ofthedove/tv-timer/pcbs/TV Timer - Digit.dxf

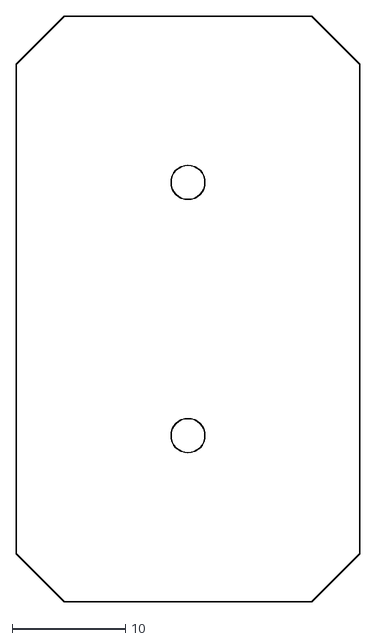
[picture p4: CAD file, 2026-08-09]
pcbs/TV Timer - Digit.dxf
30.4 x 51.7
