ofthedove/tv-timer/pcbs/TV Timer - Colon - Frame.dxf

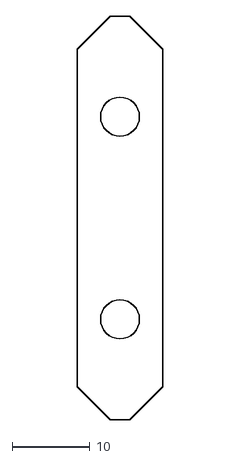
[picture p5: CAD file, 2026-08-08]
pcbs/TV Timer - Colon - Frame.dxf
11.0 x 51.7
