ofthedove/tv-timer/pcbs/TV Timer - Keypad.dxf

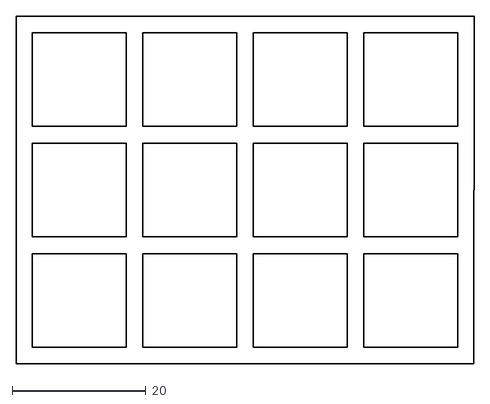
[picture p6: CAD file, 2026-08-08]
pcbs/TV Timer - Keypad.dxf
68.4 x 51.9
