ofthedove/tv-timer/pcbs/TV Timer - Indicators.dxf

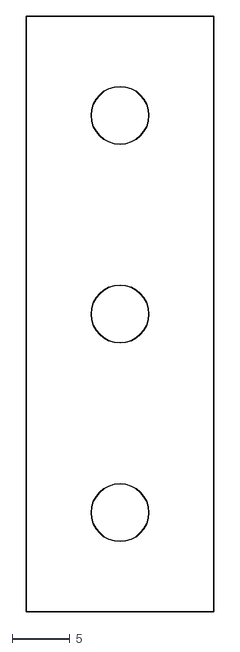
[picture p7: CAD file, 2026-08-08]
pcbs/TV Timer - Indicators.dxf
16.2 x 51.7
