ofthedove/tv-timer/pcbs/tv-timer-pcbs/tv-timer-pcbs.kicad_pcb

## KiCad design pcbs/tv-timer-pcbs/tv-timer-pcbs.kicad_pcb (2026-08-10)

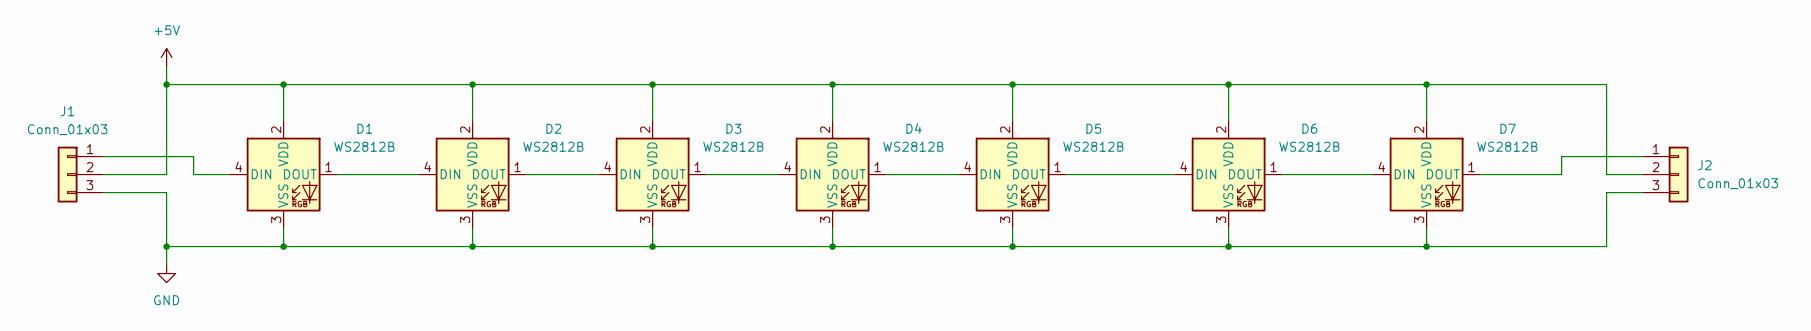
[picture p8: schematic tv-timer-pcbs.kicad_sch]

Parts:
D1, D2, D3, D4, D5, D6, D7: WS2812B; LED_D5.0mm-4_RGB_Wide_Pins
J1, J2: Conn_01x03; JST_XH_B3B-XH-AM_1x03_P2.50mm_Vertical

Connections:
+5V: D1.2 (VDD), D2.2 (VDD), D3.2 (VDD), D4.2 (VDD), D5.2 (VDD), D6.2 (VDD), D7.2 (VDD), J1.2, J2.2
GND: D1.3 (VSS), D2.3 (VSS), D3.3 (VSS), D4.3 (VSS), D5.3 (VSS), D6.3 (VSS), D7.3 (VSS), J1.3, J2.3
unnamed: D1.4 (DIN), J1.1
unnamed: D1.1 (DOUT), D2.4 (DIN)
unnamed: D2.1 (DOUT), D3.4 (DIN)
unnamed: D3.1 (DOUT), D4.4 (DIN)
unnamed: D4.1 (DOUT), D5.4 (DIN)
unnamed: D5.1 (DOUT), D6.4 (DIN)
unnamed: D6.1 (DOUT), D7.4 (DIN)
unnamed: D7.1 (DOUT), J2.1

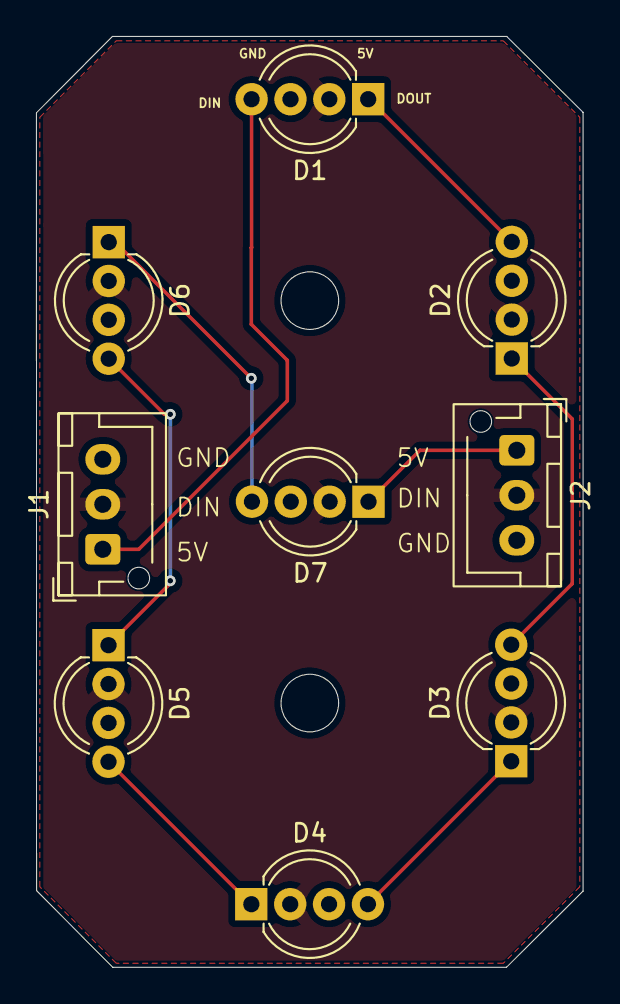
[picture p9: board tv-timer-pcbs.kicad_pcb from above]

Board: 2 copper layers, 30.4 x 51.7 mm, 9 parts (0 on the bottom side), 10 nets.
