ofthedove/tv-timer/pcbs/tv-timer-keypad/tv-timer-keypad.kicad_pcb

## KiCad design pcbs/tv-timer-keypad/tv-timer-keypad.kicad_pcb (2026-08-10)

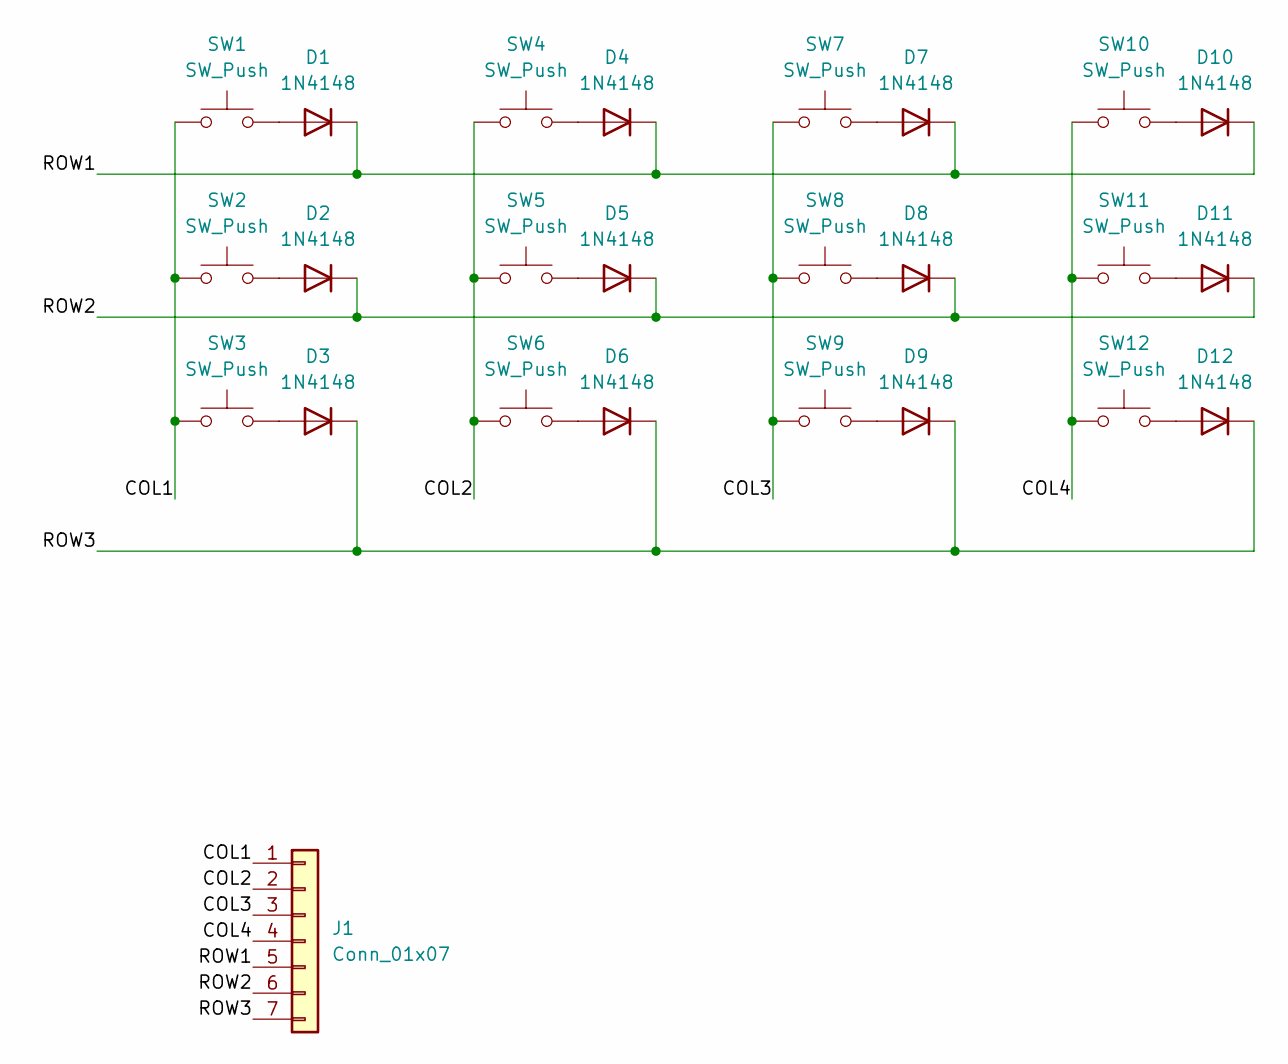
[picture p10: schematic tv-timer-keypad.kicad_sch]

Parts:
D1, D2, D3, D4, D5, D6, D7, D8, D9, D10, D11, D12: 1N4148; D_DO-35_SOD27_P7.62mm_Horizontal
J1: Conn_01x07; JST_XH_B7B-XH-AM_1x07_P2.50mm_Vertical
SW1, SW2, SW3, SW4, SW5, SW6, SW7, SW8, SW9, SW10, SW11, SW12: SW_Push; SW_Hybrid_Cherry_MX_Alps

Connections:
/COL1: J1.1, SW1.1, SW2.1, SW3.1
/COL2: J1.2, SW4.1, SW5.1, SW6.1
/COL3: J1.3, SW7.1, SW8.1, SW9.1
/COL4: J1.4, SW10.1, SW11.1, SW12.1
/ROW1: D1.1 (K), D4.1 (K), D7.1 (K), D10.1 (K), J1.5
/ROW2: D2.1 (K), D5.1 (K), D8.1 (K), D11.1 (K), J1.6
/ROW3: D3.1 (K), D6.1 (K), D9.1 (K), D12.1 (K), J1.7
unnamed: D1.2 (A), SW1.2
unnamed: D2.2 (A), SW2.2
unnamed: D3.2 (A), SW3.2
unnamed: D4.2 (A), SW4.2
unnamed: D5.2 (A), SW5.2
unnamed: D6.2 (A), SW6.2
unnamed: D7.2 (A), SW7.2
unnamed: D8.2 (A), SW8.2
unnamed: D9.2 (A), SW9.2
unnamed: D10.2 (A), SW10.2
unnamed: D11.2 (A), SW11.2
unnamed: D12.2 (A), SW12.2

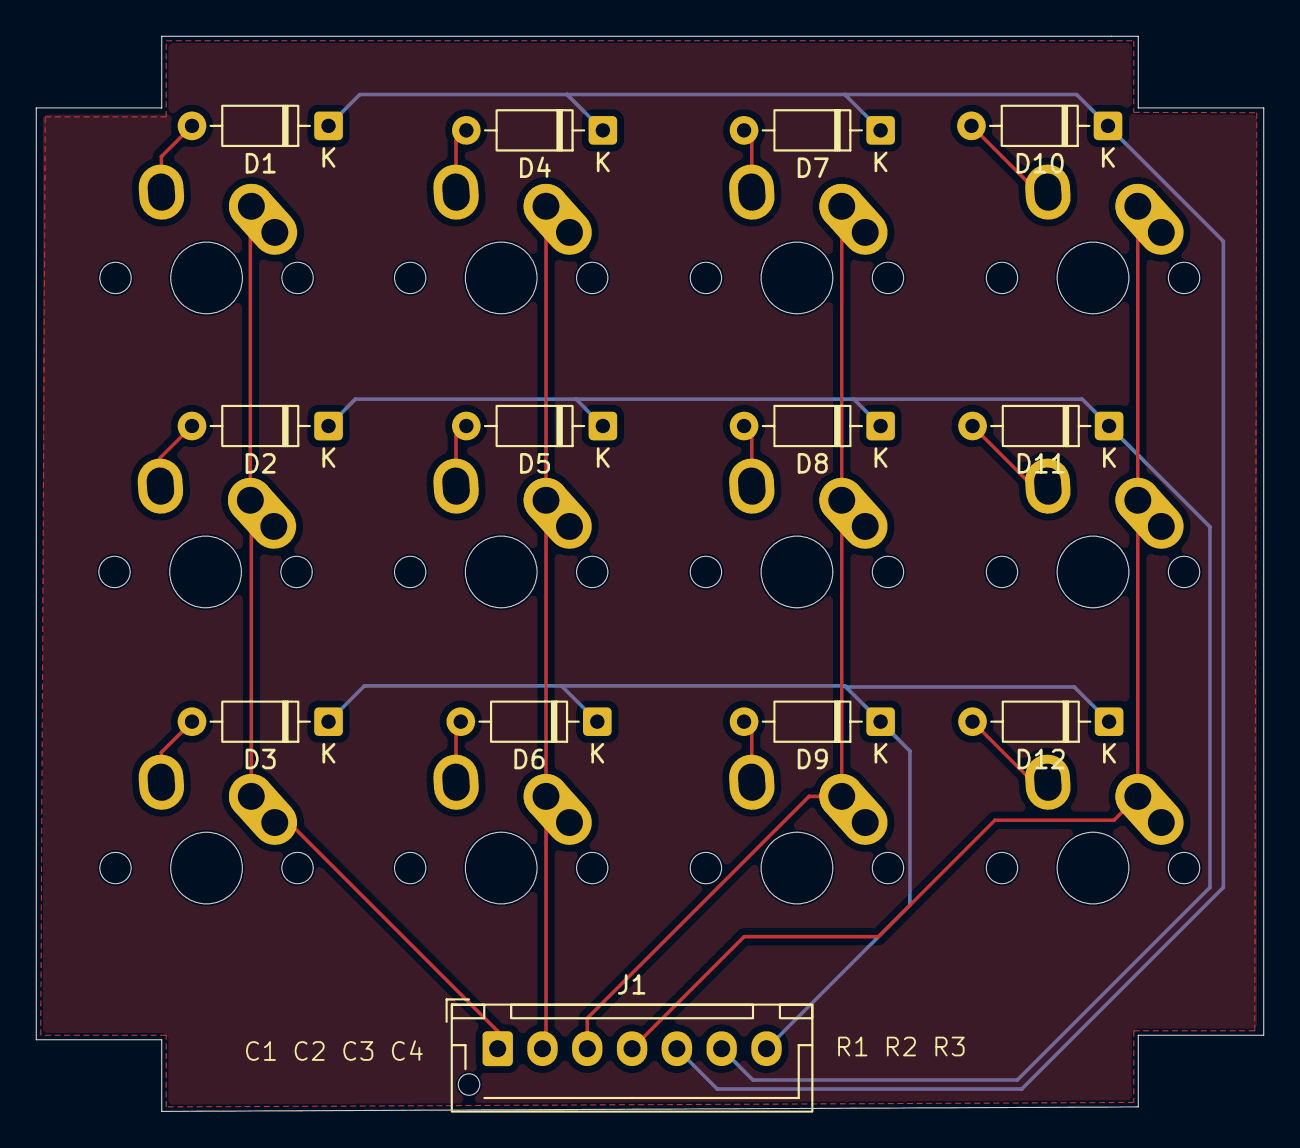
[picture p11: board tv-timer-keypad.kicad_pcb from above]

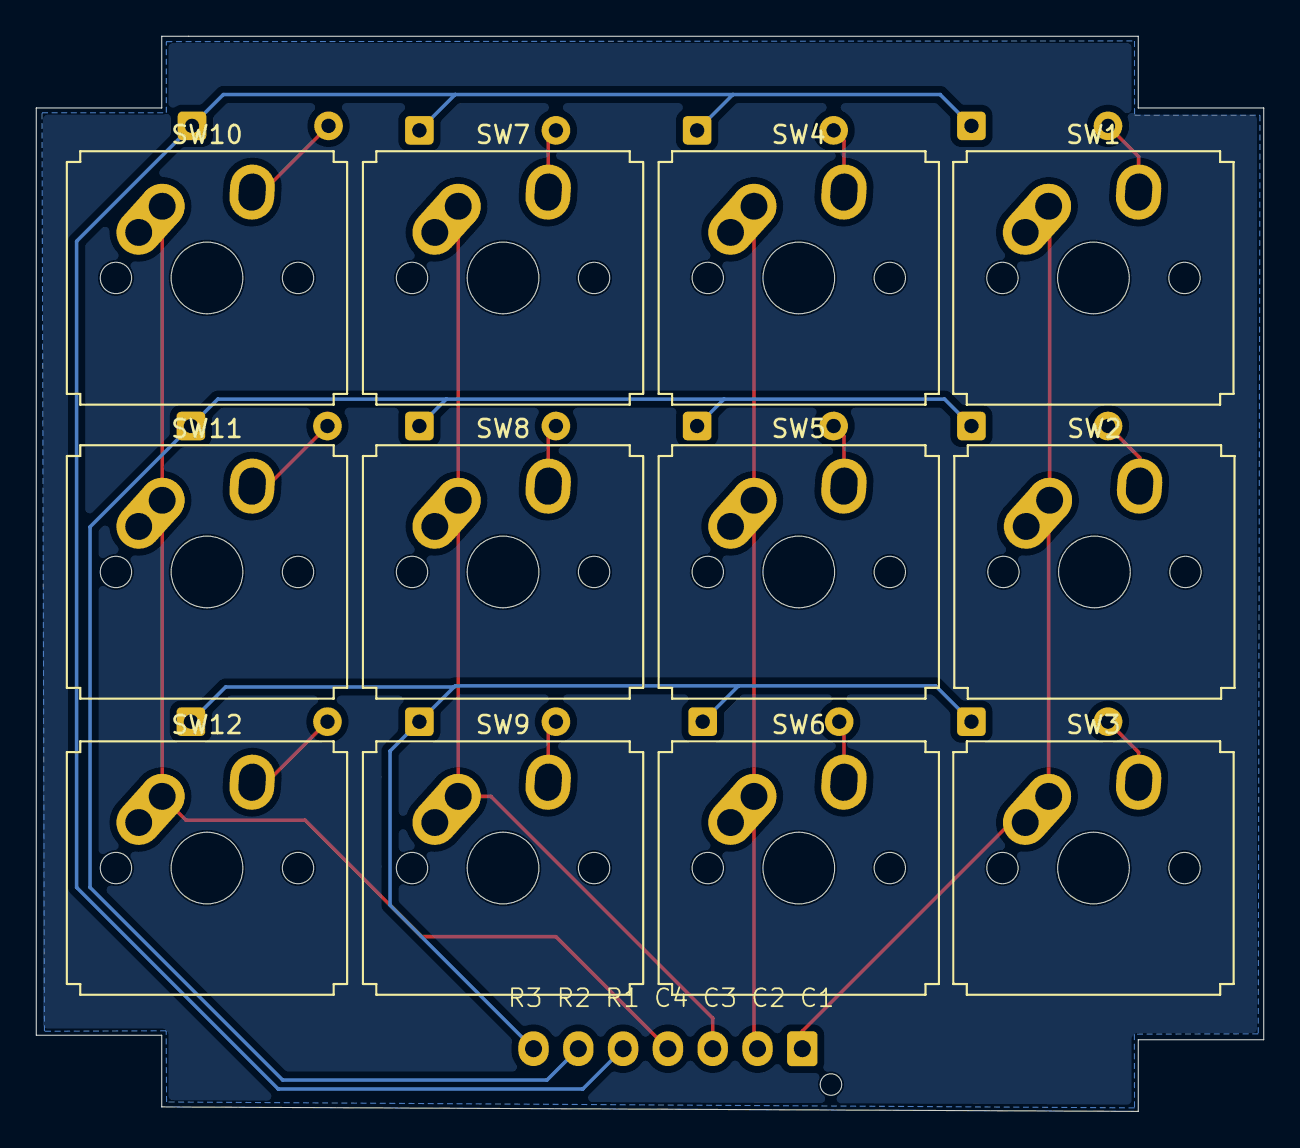
[picture p12: board tv-timer-keypad.kicad_pcb from below]

Board: 2 copper layers, 68.5 x 60.0 mm, 25 parts (12 on the bottom side), 19 nets.
