ofthedove/tv-timer/docs/assets/tv-timer-clock-pre-assembly.jpg

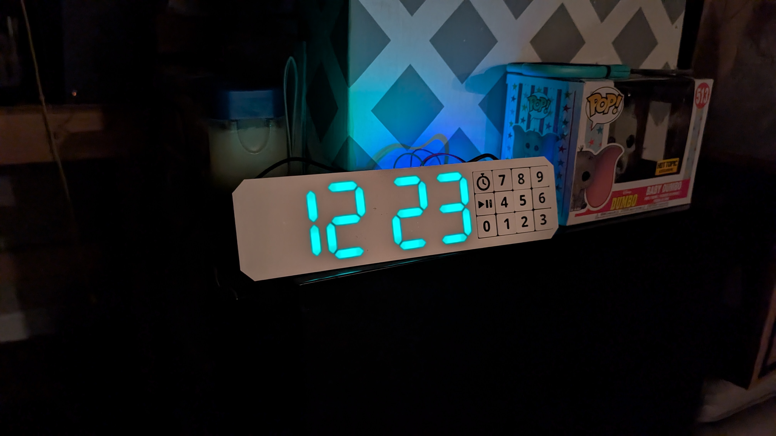
docs/assets/tv-timer-clock-pre-assembly.jpg
