ofthedove/tv-timer/(commit log)

2026-08-08 initial commit
    PCB created. Need to fix annular width
    [TV Timer - Colon - Frame.dxf, TV Timer - Digit.dxf, TV Timer - Indicators.dxf, TV Timer - Keypad.dxf, tv-timer-pcbs.kicad_pcb, tv-timer-pcbs.kicad_sch]
2026-08-09 Digit ready to go
    [TV Timer - Digit.dxf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]
2026-08-10 ordered
    Added other boards and ordered all three
    [tv-timer-indicators-B_Cu.gbr, tv-timer-indicators-B_Mask.gbr, tv-timer-indicators-B_Paste.gbr, tv-timer-indicators-B_Silkscreen.gbr, tv-timer-indicators-Edge_Cuts.gbr, tv-timer-indicators-F_Cu.gbr, tv-timer-indicators-F_Mask.gbr, tv-timer-indicators-F_Paste.gbr]
2026-08-24 Add prototype code
2026-09-12 working clock
    Forgot to commit this when I did it apparently. It's been working as a clock for a little while now. At this stage it only has the digits
